CRETATECH/CRETA-WiFarm/02_Output/Mini-ver/ESP8266_UpdateFrame/README.txt

Version: new Frame ESP-STM
	new Json ESP-APP
	Checktime out
	not include func 0x04
