CRETATECH/CRETA-WiFarm/04_Reference/1_ESP8266/1_Environment & Tools/Mesh/README.txt

1. Install ArduinoJson first.
2. Install painless from painlessMesh-master.zip
