CRETATECH/CRETA-WiFarm/05 Release/04 Environment/01 Tool_Download_App_ESP/ESP_Download_application.docx

Nạp code bằng USB UART:

Kết nối RX, TX, Vcc (3.3v), GND của USB UART và ESP8266

Nối chân GPIO0 xuống GND và ấn reset thì ESP sẽ vào trạng thái nạp code. Sau khi nạp code xong thì ESP sẽ tự về trạng thái bình thường

Nạp code bằng file .bin:

Tạo flie .bin: Sketch -> Export Compiled Binary

Dùng phần mềm Flash Download tool v2.4

Cấu hình như hình:

- SPI speed 40Mhz
- Spi mode: DIO
- Flash size 32bit
- Baudrate: 115200
- Com port

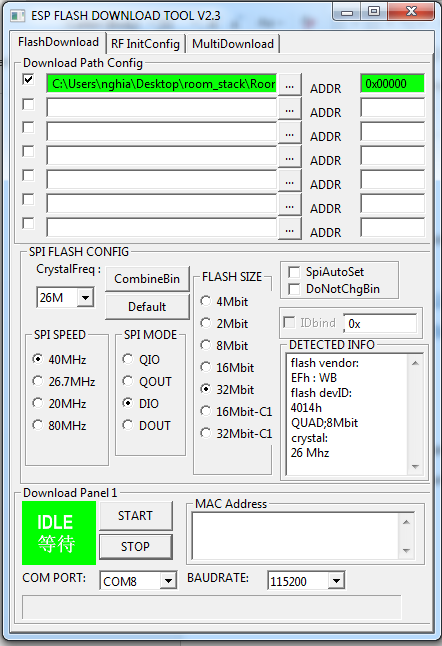
[picture p2: figure]
