CRETATECH/CRETA-WiFarm/05 Release/04 Environment/02 ESP/version_reference.docx

Các version của thư viện Arduino dùng cho ESP

ESP8266 v7

Arduino IDE: 1.6.5

ArduinoJson v5.5.1: https://github.com/bblanchon/ArduinoJson

PubSub (MQTT) v 2.5.0: https://github.com/Imroy/pubsubclient

Version board ESP: 2.0.0.
