CRETATECH/CRETA-WiFarm/05 Release/01 Documents/Frame_ESP_APP.docx

CẤU TRÚC CHUỖI JSON GIAO TIẾP GIỮA ESP VÀ APP

{“user” : “y”, "func" : "x", "addr" : "x" , "year" : "x" , "mon" : "x" , "day" : "x" , "hour" : "x" , "min" : "x" , "data" : "x"}

Trong đó:

Root | Chức năng | Giá trị | Ghi chú
“func” | Lệnh yêu cầu từ app | “1”, “2”, “3”
“addr” | Địa chỉ của thiết bị | “1”, “2”, “3” ,…
“year” | Năm
“mon” | Tháng
“day” | Ngày
“hour” | Giờ
“min” | Phút
“data” | Dữ liệu
“user” | Người dùng | | Hiện thời chưa quan trọng trường này

Chú ý: x là số nguyên, không phải số hex
