CRETATECH/CRETA-WiFarm/05 Release/03 Design/02 STM/STM flowchart.jpg

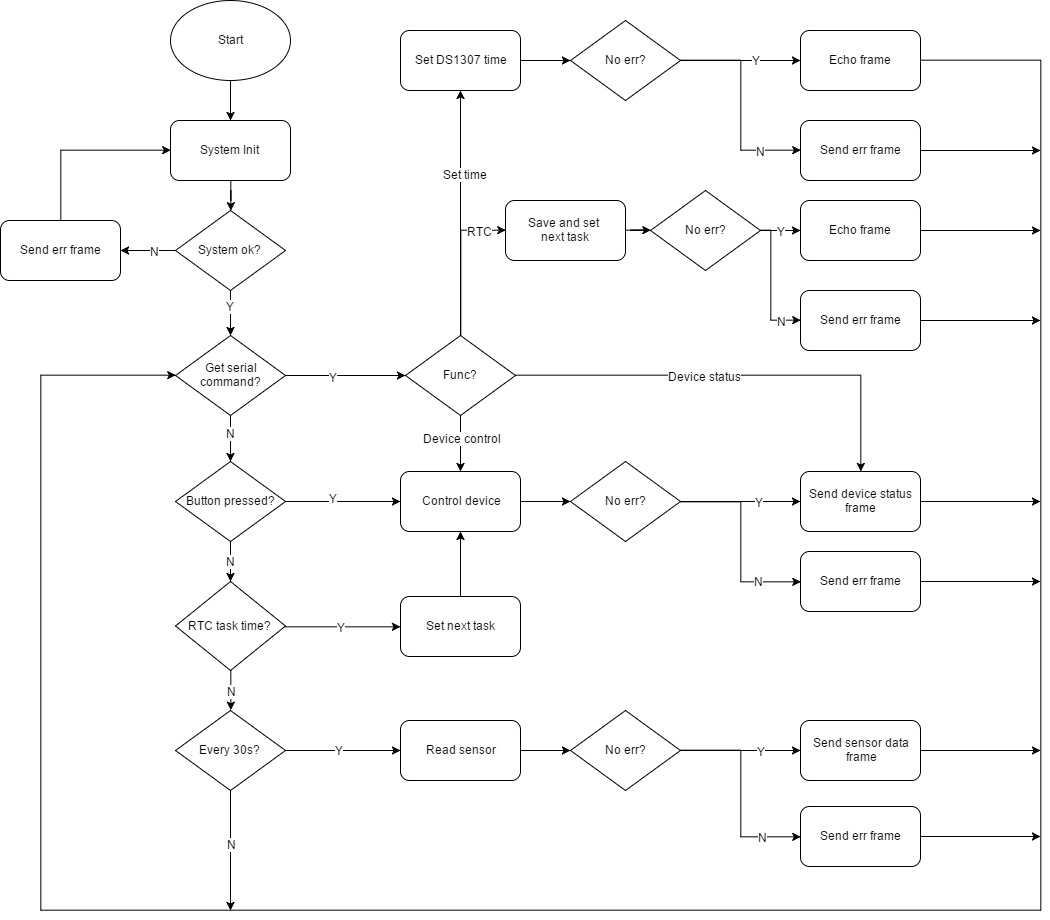
05 Release/03 Design/02 STM/STM flowchart.jpg
