CRETATECH/CRETA-WiFarm/03_workspace/Huy/Test_STM/README.txt

HOW TO USE TEST PROJECT

1/ Connect ST-Link and STM8 (RST, SWIM, VCC, GND)
2/ Open "test.eww" in STM8_testProject\Project.
3/ Make (F7).
4/ Download (Ctrl+D).
5/ Run (F5).
6/ Open Test_STM.docx to check the board ok or not.
