CRETATECH/CRETA-WiFarm/03_workspace/Huy/Test_STM/Test_STM.docx

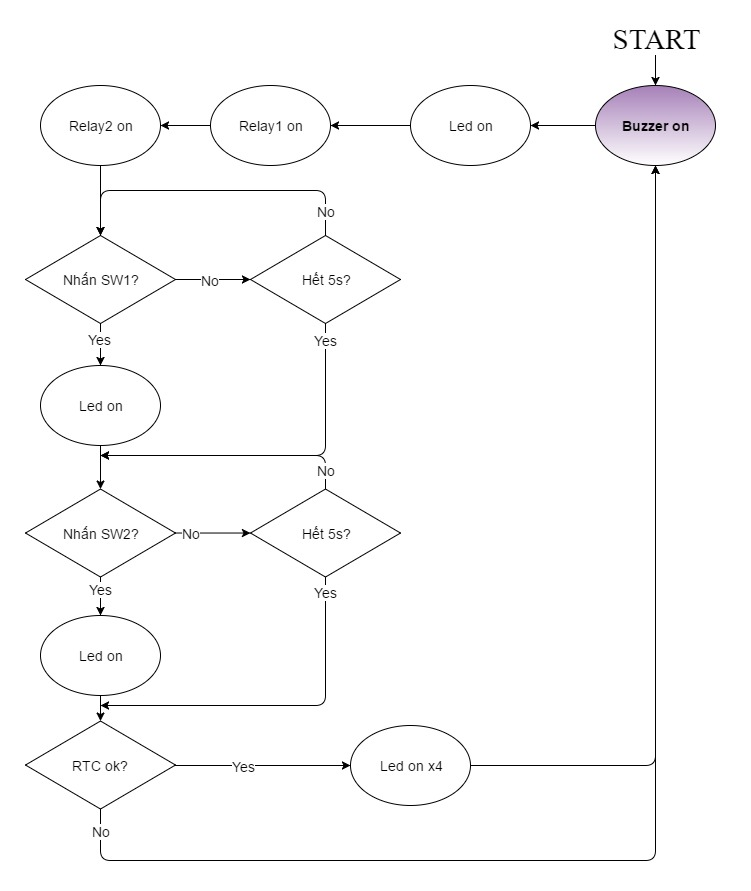
[picture p9: figure]

Sau khi nạp file hex vào trong STM8. Mạch sẽ có các hiện tượng lần lượt sau:

Để kiểm chứng độ chính xác của code test. Firmware đã thực hiện nó trên testboard mô phỏng lại các thiết bị thông qua led. Với thứ tự led như sau:

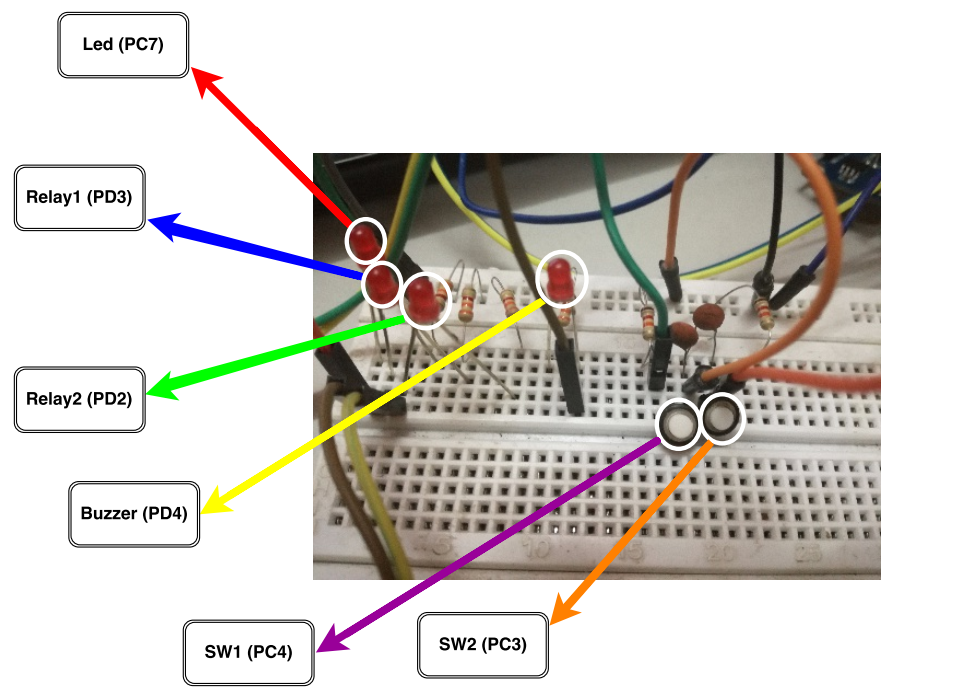
[picture p10: figure]

Hiện tượng ở sơ đồ trên sẽ được thể hiện qua clip đính kèm.
