CRETATECH/CRETA-WiFarm/03_workspace/Nghia/rewifarm/WiFarm/WiFarm.h

#ifndef WIFARM_H_
#define WIFARM_H_
#define BUFFER_SIZE         1000

#define PIN_CONFIG          0
#define PIN_LED             5
                    
#define TOPIC_IN            (String)("server/esp000021")
#define TOPIC_OUT           (String)("device/esp000021")

#define LOCAL_CONTROL       0x02
#define REMOTE_CONTROL      0x01

#endif
