CRETATECH/CRETA-WiFarm/02_Output/Mini-ver/STM8S103_UpdateFrame/3_User/5_Main/main.c

#include "stm8s.h"
#include "StateMachine.h"

void main (void)
{
    stateInit();

    while(1)
    {
        stateUpdate();
        stateMachine();
    }
}

#ifdef USE_FULL_ASSERT

/**
  * @brief  Reports the name of the source file and the source line number
  *   where the assert_param error has occurred.
  * @param file: pointer to the source file name
  * @param line: assert_param error line source number
  * @retval : None
  */
void assert_failed(u8* file, u32 line)
{
  /* User can add his own implementation to report the file name and line number,
     ex: printf("Wrong parameters value: file %s on line %d\r\n", file, line) */

  /* Infinite loop */
  /*
  while (1)
  {
  }
  */
}
#endif
