CRETATECH/CRETA-WiFarm/02_Output/Mini-ver/STM8S103_UpdateFrame/3_User/4_StateMachine/StateMachine.h

/*******************************************************************************
  * @filename   : StateMachine.h
  * @author     : HgN
  * @last update: July 19th, 2017
  */
/******************************************************************************/
#ifndef STATE_H
#define STATE_H

/******************************************************************************/
/* INCLUDE */
/******************************************************************************/
#include "stm8s.h"
#include "serialProtocol.h"
#include "rtc.h"
#include "sht1x.h"
#include "button.h"
#include "device.h"
#include "uart.h"

/******************************************************************************/
/* PUBLIC TYPEDEFS */
/******************************************************************************/

/******************************************************************************/
/* PUBLIC DEFINES */
/******************************************************************************/
#define STATE_IDLE 1
#define STATE_CMD  2
#define STATE_SENSOR 3
#define STATE_DEVICE 4
#define STATE_RTC 5

#define SENSOR_GAP 30

/******************************************************************************/
/* PUBLIC FUNCTION PROTOTYPES */
/******************************************************************************/
void stateInit(void);
void stateUpdate(void);
void stateMachine(void);

#endif
/******************************************************************************/
/* END OF FILE */
/******************************************************************************/
