CRETATECH/CRETA-WiFarm/02_Output/Mini-ver/STM8S103_UpdateFrame/3_User/2_Driver/sht1x.c

/*******************************************************************************
  * @filename   : sht1x.c
  * @author     : HgN
  * @last update: July 19th, 2017
  */
/******************************************************************************/

/******************************************************************************/
/* REVISION HISTORY */
// March 17: Initialization.
// July 19: Update Project, clean file
/******************************************************************************/

/******************************************************************************/
/* INCLUDE */
/******************************************************************************/
#include "sht1x.h"
#include <stdbool.h>
#include <stdlib.h>

/******************************************************************************/
/* LOCAL TYPEDEFS */
/******************************************************************************/

/******************************************************************************/
/* LOCAL DEFINES */
/******************************************************************************/
const float d1 = -39.6;
const float d2 = 0.01;

const float c1 = -4;
const float c2 = 0.0405;
const float c3 = -2.8E-6;
const float t1 = 0.01;
const float t2 = 0.00008;
/******************************************************************************/
/* PUBLIC VARIABLES */
/******************************************************************************/

/******************************************************************************/
/* LOCAL FUNCTION PROTOTYPES */
/******************************************************************************/
static void shtStart();
static void shtCmd(uint8_t cmd);
static uint8_t shtCheckACK();
static uint8_t shtWaitConvert();
static uint16_t shtReadRaw();

/******************************************************************************/
/* PUBLIC FUNCTIONS */
/******************************************************************************/
/**
 * @brief To init SHT10
 * @param None
 */
void shtInit(void)
{
    // Just delay to power up
    uint32_t _sht_startup_delay = 0xFFFFF;
    while(_sht_startup_delay --);
}
/**
 * @brief To read temperature
 * @param *temp
 * @ret
 *      EXIT_SUCCESS
 *      EXIT_FAILURE
 */
int shtReadTemp(float *temp)
{
    float ftemp;

    shtStart();
    shtCmd(SHT_CMD_TEMP);
    if(shtCheckACK() == EXIT_FAILURE)
        return EXIT_FAILURE;
    if(EXIT_FAILURE == shtWaitConvert())
        return EXIT_FAILURE;
    ftemp = shtReadRaw();
    ftemp = d1 + d2*ftemp;
    *temp = ftemp;
    return EXIT_SUCCESS;
}
/**
 * @brief To read humid
 * @param *temp
 * @ret
 *      EXIT_SUCCESS
 *      EXIT_FAILURE
 */
int shtReadHumid(float *humid)
{

    float rhumid;
    float ftemp;
    float fhumidl;
    float fhumid;
    shtStart();
    shtCmd(SHT_CMD_HUMID);
    if(shtCheckACK() == EXIT_FAILURE)
        return EXIT_FAILURE;
    if(EXIT_FAILURE == shtWaitConvert())
        return EXIT_FAILURE;
    rhumid = (shtReadRaw());
    fhumidl = c1 + c2*rhumid + c3*rhumid*rhumid;
    shtReadTemp(&ftemp);
    fhumid = (ftemp - 25)*(t1 + t2*rhumid)+fhumidl;
    *humid = fhumidl;
    return EXIT_SUCCESS;
}

/******************************************************************************/
/* LOCAL FUNCTIONS */
/******************************************************************************/
/**
 * @brief To send start signal
 * @param None
 */
static void shtStart(void)
{
    gpioPinMode(SHT_PORT, SHT_SCK_PIN, GPIO_MODE_OUT_PP_HIGH_FAST);
    gpioPinMode(SHT_PORT, SHT_SDA_PIN, GPIO_MODE_OUT_PP_HIGH_FAST);
    gpioWritePin(SHT_PORT, SHT_SCK_PIN, GPIO_LOW);
    gpioWritePin(SHT_PORT, SHT_SDA_PIN, GPIO_HIGH);
    gpioWritePin(SHT_PORT, SHT_SCK_PIN, GPIO_HIGH);
    gpioWritePin(SHT_PORT, SHT_SDA_PIN, GPIO_LOW);
    gpioWritePin(SHT_PORT, SHT_SCK_PIN, GPIO_LOW);
    gpioWritePin(SHT_PORT, SHT_SCK_PIN, GPIO_HIGH);
    gpioWritePin(SHT_PORT,SHT_SDA_PIN, GPIO_HIGH);
    gpioWritePin(SHT_PORT, SHT_SCK_PIN, GPIO_LOW);
}

/**
 * @brief To send a command
 * @param pCmd
 */
static void shtCmd(uint8_t pCmd)
{
    uint8_t _sht_cmd_mask = 0x80;
    int i;
    for(i=0; i<8; i++)
    {
        if((pCmd & _sht_cmd_mask) != 0)
            gpioWritePin(SHT_PORT, SHT_SDA_PIN, GPIO_HIGH);
        else
            gpioWritePin(SHT_PORT, SHT_SDA_PIN, GPIO_LOW);
        gpioWritePin(SHT_PORT, SHT_SCK_PIN, GPIO_LOW);
        gpioWritePin(SHT_PORT, SHT_SCK_PIN, GPIO_HIGH);
        gpioWritePin(SHT_PORT, SHT_SCK_PIN, GPIO_LOW);
        _sht_cmd_mask = _sht_cmd_mask >> 1;
    }
}

/**
 * @brief To check SHT ACK
 * @param None
 * @ret
 *      EXIT_SUCCESS
 *      EXIT_FAILURE
 */
static uint8_t shtCheckACK(void)
{
    gpioPinMode(SHT_PORT, SHT_SDA_PIN, GPIO_MODE_IN_FL_NO_IT);
    if(gpioReadPin(SHT_PORT, SHT_SDA_PIN) != GPIO_LOW)
        return EXIT_FAILURE;
    gpioWritePin(SHT_PORT, SHT_SCK_PIN, GPIO_LOW);
    gpioWritePin(SHT_PORT, SHT_SCK_PIN, GPIO_HIGH);
    gpioWritePin(SHT_PORT, SHT_SCK_PIN, GPIO_LOW);
    if(gpioReadPin(SHT_PORT, SHT_SDA_PIN) == GPIO_LOW)
        return EXIT_FAILURE;
    return EXIT_SUCCESS;
}
/**
 * @brief To wait for SHT convertion
 * @param None
 * @ret
 *      EXIT_SUCCESS
 *      EXIT_FAILURE
 */
static uint8_t shtWaitConvert()
{
    uint16_t time_out = 0xFFFF;
    gpioPinMode(SHT_PORT, SHT_SDA_PIN, GPIO_MODE_IN_FL_NO_IT);
    while((gpioReadPin(SHT_PORT, SHT_SDA_PIN) != GPIO_LOW)||(time_out == 0))
        time_out--;
    if(0 == time_out)
        return EXIT_FAILURE;
    else
        return EXIT_SUCCESS;
}
/**
 * @brief To read raw data
 * @param None
 * @ret   Raw data
 */
static uint16_t shtReadRaw(void)
{
    uint16_t _sht_data_raw = 0x0000;
    int i;
    for(i=0; i<8; i++)
    {
        gpioWritePin(SHT_PORT, SHT_SCK_PIN, GPIO_LOW);
        gpioWritePin(SHT_PORT, SHT_SCK_PIN, GPIO_HIGH);
        _sht_data_raw = _sht_data_raw << 1;
        if(gpioReadPin(SHT_PORT, SHT_SDA_PIN) != GPIO_LOW)
            _sht_data_raw |= 0x0001;
        gpioWritePin(SHT_PORT, SHT_SCK_PIN, GPIO_LOW);
    }
    gpioPinMode(SHT_PORT, SHT_SDA_PIN, GPIO_MODE_OUT_PP_HIGH_FAST);
    gpioWritePin(SHT_PORT, SHT_SDA_PIN, GPIO_LOW);
    gpioWritePin(SHT_PORT, SHT_SCK_PIN, GPIO_LOW);
    gpioWritePin(SHT_PORT, SHT_SCK_PIN, GPIO_HIGH);
    gpioWritePin(SHT_PORT, SHT_SCK_PIN, GPIO_LOW);
    gpioPinMode(SHT_PORT, SHT_SDA_PIN, GPIO_MODE_IN_FL_NO_IT);
    for(i=0; i<8; i++)
    {
        gpioWritePin(SHT_PORT,SHT_SCK_PIN, GPIO_LOW);
        gpioWritePin(SHT_PORT,SHT_SCK_PIN, GPIO_HIGH);
        _sht_data_raw = _sht_data_raw << 1;
        if(gpioReadPin(SHT_PORT, SHT_SDA_PIN) != GPIO_LOW)
            _sht_data_raw |= 0x0001;
        gpioWritePin(SHT_PORT,SHT_SCK_PIN, GPIO_LOW);
    }
    gpioPinMode(SHT_PORT, SHT_SDA_PIN, GPIO_MODE_OUT_PP_HIGH_FAST);
    gpioWritePin(SHT_PORT, SHT_SDA_PIN, GPIO_HIGH);
    gpioWritePin(SHT_PORT, SHT_SCK_PIN, GPIO_LOW);
    gpioWritePin(SHT_PORT, SHT_SCK_PIN, GPIO_HIGH);
    gpioWritePin(SHT_PORT, SHT_SCK_PIN, GPIO_LOW);
    return _sht_data_raw;
}

/******************************************************************************/
/* END OF FILE */
/******************************************************************************/
