CRETATECH/CRETA-WiFarm/02_Output/Mini-ver/STM8S103_UpdateFrame/3_User/1_HAL/eeprom.h

/*******************************************************************************
  * @filename   : epprom.h
  * @author     : HgN
  * @last update: July 19th, 2017
  */
/******************************************************************************/

#ifndef EEPROM_H
#define EEPROM_H

/******************************************************************************/
/* INCLUDE */
/******************************************************************************/
#include "stm8s.h"

/******************************************************************************/
/* PUBLIC TYPEDEFS */
/******************************************************************************/

/******************************************************************************/
/* PUBLIC DEFINES */
/******************************************************************************/
#define EEPROM_START_ADDR   0x004000
#define EEPROM_END_ADDR     0x00427F
/******************************************************************************/
/* PUBLIC FUNCTION PROTOTYPES */
/******************************************************************************/
void eepromInit();
void eepromClear();
int eepromWrite(uint32_t pAddr, uint8_t *pData, uint8_t pLength);
int eepromRead(uint32_t pAddr, uint8_t *pBuff, uint8_t pLength);

#endif
/******************************************************************************/
/* END OF FILE */
/******************************************************************************/
