CRETATECH/CRETA-WiFarm/02_Output/Mini-ver/STM8S103_UpdateFrame/3_User/1_HAL/uart.h

/*******************************************************************************
  * @filename   : uart.h
  * @author     : HgN
  * @last update: July 19th, 2017
  */
/******************************************************************************/

#ifndef		UART_H
#define		UART_H

/******************************************************************************/
/* INCLUDE */
/******************************************************************************/
#include "stm8s.h"

/******************************************************************************/
/* PUBLIC TYPEDEFS */
/******************************************************************************/
#define UART_BUFFER_MAX 128

/******************************************************************************/
/* PUBLIC DEFINES */
/******************************************************************************/
#define	B9600		     9600
#define	B57600		     57600
#define	B115200		     115200

/******************************************************************************/
/* PUBLIC FUNCTION PROTOTYPES */
/******************************************************************************/
int uartInit(uint32_t pBaudRate);
uint8_t	uartRead(void);
uint8_t uartAvailable(void);
void uartWrite(uint8_t * pData, uint8_t pLength);
void uartWriteByte(uint8_t pByte);

#endif		//UART_H

/******************************************************************************/
/* END OF FILE */
/******************************************************************************/
