CRETATECH/CRETA-WiFarm/02_Output/Mini-ver/STM8S103_UpdateFrame/3_User/2_Driver/button.h

/*******************************************************************************
  * @filename   : button.h
  * @author     : HgN
  * @last update: July 19th, 2017
  */
/******************************************************************************/

#ifndef BUTTON_H
#define BUTTON_H

/******************************************************************************/
/* INCLUDE */
/******************************************************************************/
#include "defineHardware.h"
/******************************************************************************/
/* PUBLIC TYPEDEFS */
/******************************************************************************/

/******************************************************************************/
/* PUBLIC DEFINES */
/******************************************************************************/
#define BUTTON_DEBOUND_DELAY 50;
/******************************************************************************/
/* PUBLIC FUNCTION PROTOTYPES */
/******************************************************************************/
void buttonInit(void);
uint8_t buttonCheck(uint8_t pButton);

#endif
/******************************************************************************/
/* END OF FILE */
/******************************************************************************/
