CRETATECH/CRETA-WiFarm/02_Output/Mini-ver/STM8S103_UpdateFrame/3_User/2_Driver/device.h

/*******************************************************************************
  * @filename   : device.h
  * @author     : HgN
  * @last update: July 19th, 2017
  */
/******************************************************************************/

#ifndef DEVICE_H
#define DEVICE_H

/******************************************************************************/
/* INCLUDE */
/******************************************************************************/
#include "stm8s.h"
#include "defineHardware.h"

/******************************************************************************/
/* PUBLIC TYPEDEFS */
/******************************************************************************/

/******************************************************************************/
/* PUBLIC DEFINES */
/******************************************************************************/

/******************************************************************************/
/* PUBLIC FUNCTION PROTOTYPES */
/******************************************************************************/
void deviceInit();
void deviceControl(uint8_t pDevice, uint8_t pValue);
uint8_t deviceRead(uint8_t pDevice);

#endif
/******************************************************************************/
/* END OF FILE */
/******************************************************************************/
