CRETATECH/CRETA-WiFarm/02_Output/Mini-ver/STM8S103_UpdateFrame/3_User/2_Driver/ds1307.h

/*******************************************************************************
  * @filename   : ds1307.h
  * @author     : HgN
  * @last update: July 19th, 2017
  */
/******************************************************************************/


#ifndef __DS1307_H__
#define __DS1307_H__

/******************************************************************************/
/* INCLUDE */
/******************************************************************************/
#include "i2c.h"

/******************************************************************************/
/* PUBLIC TYPEDEFS */
/******************************************************************************/

/******************************************************************************/
/* PUBLIC DEFINES */
/******************************************************************************/
#define DS1307_ADDRESS   (uint8_t)0xD0
#define DS1307_REG_SEC   0x00
#define DS1307_REG_MIN   0x01
#define DS1307_REG_HOUR  0x02
#define DS1307_REG_DAY   0x04
#define DS1307_REG_MONTH 0x05
#define DS1307_REG_YEAR  0x06

/******************************************************************************/
/* PUBLIC FUNCTION PROTOTYPES */
/******************************************************************************/
int ds1307SetTime(uint8_t pYear, uint8_t pMonth, uint8_t pDay, uint8_t pHour, uint8_t pMin);
int ds1307Read(uint8_t pRegAdd, uint8_t *pData);

#endif //BH1750
/******************************************************************************/
/* END OF FILE */
/******************************************************************************/
