CRETATECH/CRETA-WiFarm/02_Output/Mini-ver/STM8S103_UpdateFrame/3_User/2_Driver/sht1x.h

/*******************************************************************************
  * @filename   : sht1x.c
  * @author     : HgN
  * @last update: July 19th, 2017
  */
/******************************************************************************/
#ifndef SHT_H
#define SHT_H

/******************************************************************************/
/* INCLUDE */
/******************************************************************************/
#include "stm8s.h"
#include "defineHardware.h"

/******************************************************************************/
/* PUBLIC TYPEDEFS */
/******************************************************************************/

/******************************************************************************/
/* PUBLIC DEFINES */
/******************************************************************************/
#define SHT_CMD_TEMP    (uint8_t)0x03
#define SHT_CMD_HUMID   (uint8_t)0x05

/******************************************************************************/
/* PUBLIC FUNCTION PROTOTYPES */
/******************************************************************************/
void shtInit();
int shtReadTemp(float *temp);
int shtReadHumid(float *humid);

#endif

/******************************************************************************/
/* END OF FILE */
/******************************************************************************/
