CRETATECH/CRETA-WiFarm/02_Output/Mini-ver/STM8S103_UpdateFrame/3_User/3_Framework/rtc.h

/*******************************************************************************
  * @filename   : rtc.h
  * @author     : HgN
  * @last update: July 19th, 2017
  */
/******************************************************************************/

#ifndef RTC_H
#define RTC_H

/******************************************************************************/
/* INCLUDE */
/******************************************************************************/
#include "stm8s.h"
#include "serialProtocol.h"
#include "ds1307.h"
#include "device.h"
#include "eeprom.h"
#include "timer.h"
/******************************************************************************/
/* PUBLIC TYPEDEFS */
/******************************************************************************/

/******************************************************************************/
/* PUBLIC DEFINES */
/******************************************************************************/

/******************************************************************************/
/* PUBLIC FUNCTION PROTOTYPES */
/******************************************************************************/
int rtcInit(void);
int rtcTimerRun(void);
int rtcSetRealTime(serial_frame_t *serialRxFrame);
int rtcSaveTask(serial_frame_t* serialRxFrame);
uint32_t rtcReadTask(uint8_t pTaskNum);
void rtcSetRunningTask(void);
uint32_t rtcGetTimerSecond(void);

#endif
/******************************************************************************/
/* END OF FILE */
/******************************************************************************/
