CRETATECH/CRETA-WiFarm/03_workspace/Nghia/STM8S103_ReduceCodeSize/3_User/2_Driver/buzzer.h

/*******************************************************************************
  * @filename   : device.h
  * @author     : HgN
  * @last update: July 19th, 2017
  */
/******************************************************************************/

#ifndef BUZZER_H
#define BUZZER_H

/******************************************************************************/
/* INCLUDE */
/******************************************************************************/
#include "stm8s.h"
#include "defineHardware.h"

/******************************************************************************/
/* PUBLIC TYPEDEFS */
/******************************************************************************/

/******************************************************************************/
/* PUBLIC DEFINES */
/******************************************************************************/

/******************************************************************************/
/* PUBLIC FUNCTION PROTOTYPES */
/******************************************************************************/
void buzzerInit(void);
void buzzerBeep(uint8_t pPeriod, uint8_t pTime);
void buzzerOn(void);
void buzzerOff(void);

#endif
/******************************************************************************/
/* END OF FILE */
/******************************************************************************/
